pasumartisumanth/SAEAero-design-east-2022/prototype 2 assembly.stp

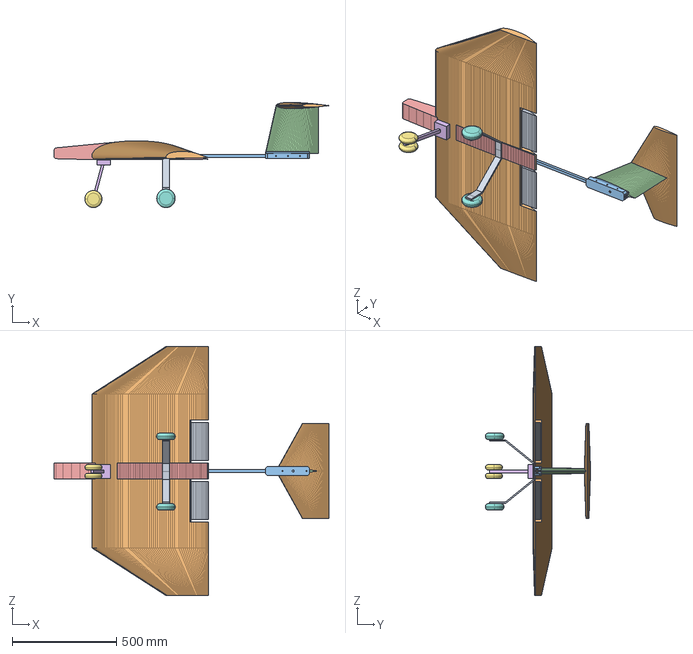
[picture p32: CAD file, 2025-08-19]
prototype 2 assembly.stp
1317.4 x 503.8 x 1193.8 mm
