pasumartisumanth/SAEAero-design-east-2022/prototype v2.stp

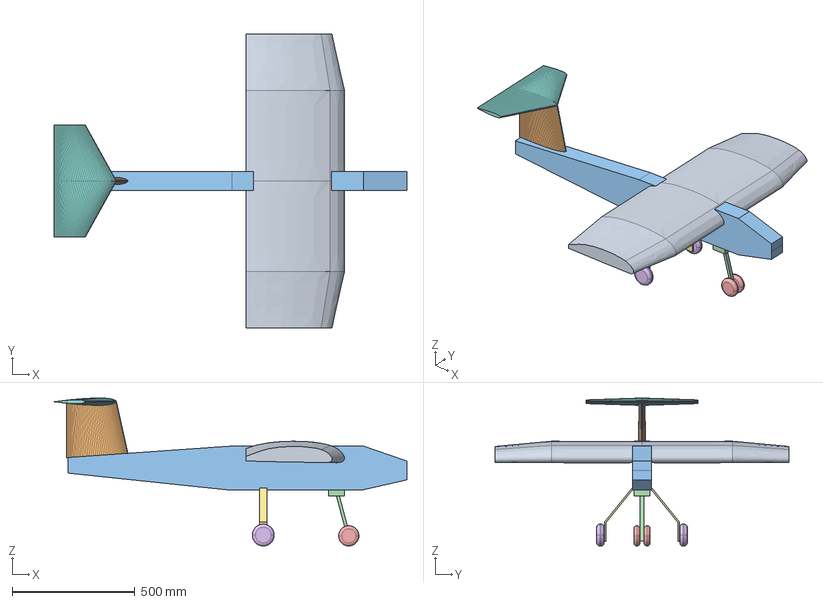
[picture p33: CAD file, 2025-08-19]
prototype v2.stp
1435.1 x 1193.8 x 601.7 mm
